Casio-Byte/Pico-Latency-Tester/LCD-Version/images/screens/08b_menu_trigger_default.png

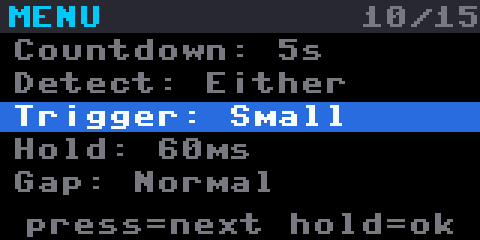
LCD-Version/images/screens/08b_menu_trigger_default.png
