Casio-Byte/Pico-Latency-Tester/LCD-Version/images/screens/09_menu_clicks.png

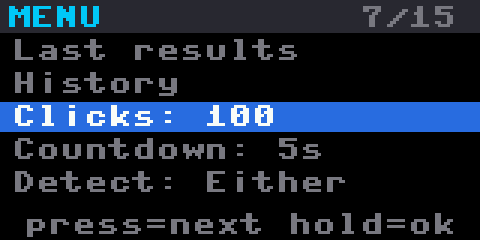
LCD-Version/images/screens/09_menu_clicks.png
