Casio-Byte/Pico-Latency-Tester/LCD-Version/images/screens/15c_flicker_dark.png

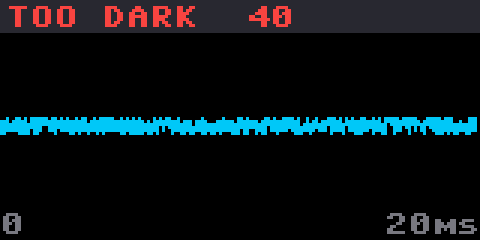
LCD-Version/images/screens/15c_flicker_dark.png
