Casio-Byte/Pico-Latency-Tester/LCD-Version/images/screens/18_flipped_menu.png

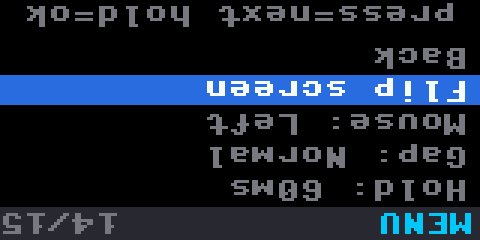
LCD-Version/images/screens/18_flipped_menu.png
