Casio-Byte/Pico-Latency-Tester/LCD-Version/images/screens/20_no_change.png

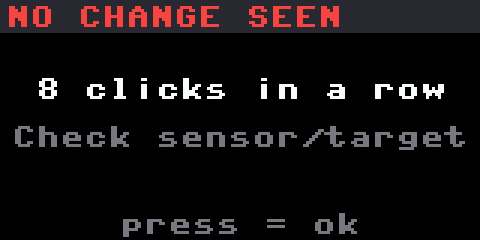
LCD-Version/images/screens/20_no_change.png
