Casio-Byte/Pico-Latency-Tester/LCD-Version/case/parametric/latency_v3_lid.stl

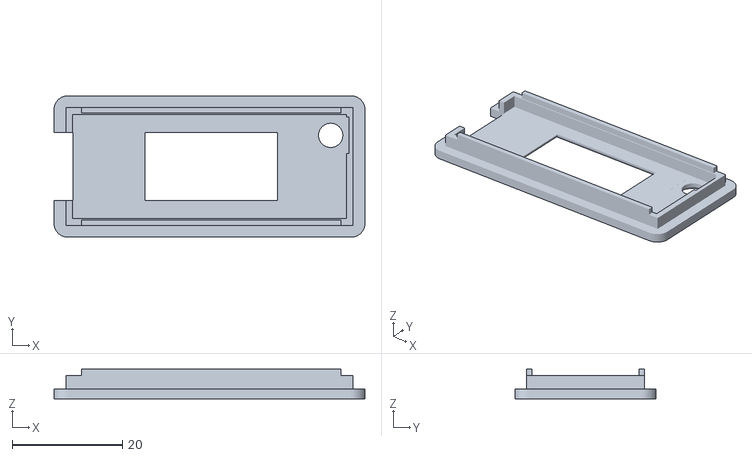
[picture p34: CAD file, 2026-10-23]
LCD-Version/case/parametric/latency_v3_lid.stl
56.3 x 25.6 x 5.40
