Casio-Byte/Pico-Latency-Tester/LCD-Version/case/parametric/latency_v3_base.stl

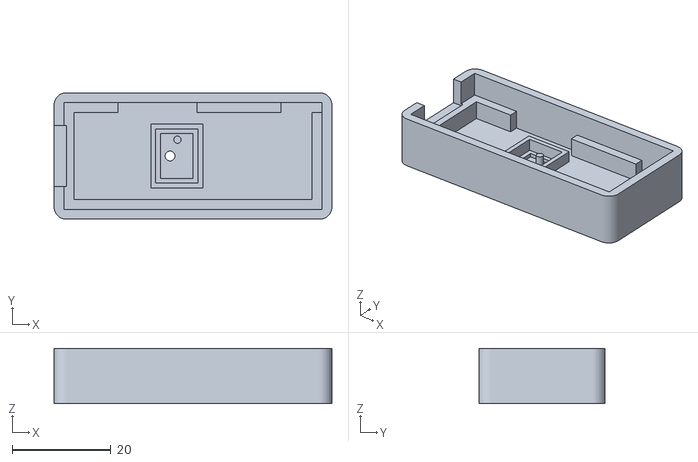
[picture p35: CAD file, 2026-10-23]
LCD-Version/case/parametric/latency_v3_base.stl
56.3 x 25.6 x 11.2
