Casio-Byte/Pico-Latency-Tester/LCD-Version/images/screens/17e_history_cleared.png

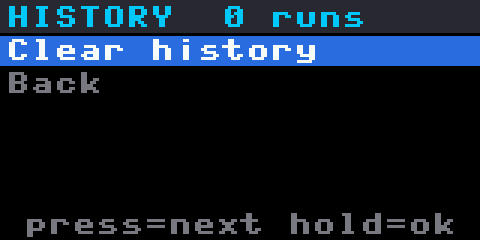
LCD-Version/images/screens/17e_history_cleared.png
