Casio-Byte/Pico-Latency-Tester/(commit log)

2026-10-23 Pico Latency Tester 2.1: Pico firmware, Windows app and write-up
    Click-to-photon latency tester built from a Raspberry Pi Pico / Pico W and an
    ALS-PT19 light sensor. The Pico acts as a USB mouse plus serial port; a native
    Windows app (C++, Dear ImGui, Direct3D 11) runs the tests.
    - Firmware: viper hot paths, free-running ADC, microsecond click-to-light timing
    - App: built-in full-screen/windowed flash target with latency breakdown,
    game/any-app test, response and flicker scope, live sensor, history and
    comparison, CSV export, firmware installer via the MicroPython raw REPL
    - Tests: core unit tests, firmware mpy-cross check, simulated-Pico Wine bench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
2026-10-23 Add standalone version 3: RP2040-LCD screen + one button, no PC app
    - standalone/: firmware for the Waveshare RP2040-LCD-0.96 with an ALS-PT19
    sensor and one button. One-button menus, auto runs with calibration,
    manual mode (button = mouse), response scope, flicker test, sensor view,
    results pages, history; settings and results saved on the board
    - lt_app.py runs unchanged against a simulated board
    (tests/sim_standalone.py) - used to test every screen and to render the
    screenshots with MicroPython's own font
    - pre-compiled .mpy modules, a simple target.html for the PC
    - README links both versions
    Claude-Session: https://claud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
2026-10-23 Standalone v3.1: remove manual test, fix flicker test, live sensor view, history browse/clear
    - Remove manual test mode (and the hardware code behind it)
    - Flicker test: countdown, holds the mouse so the target is lit, no longer
    runs out of memory (no 16000-item sorted copy; capture buffer allocated
    once at boot), shows TOO DARK when the sensor sees no light
    - Any out-of-memory error in a menu action now shows a message instead of
    crashing
    - Sensor view redraws every sample; press sends a click, hold goes back
    - History: browse every run, open one for its detail, clear all (confirmed)
    - Trigger defaults to Small; existing boards are moved over once
    - Simulator: 84 steps covering the ne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
    [lt_app.py, lt_hw.py]
2026-10-23 Standalone: button moves to GP16 (pin 21) and GND (pin 23)
    Claude-Session: https://claude.ai/code/session_01NdawBg2AjAfE4fo9pBicW9
2026-10-23 Standalone: 3D-printed case for the RP2040-LCD-0.96
    Screen through the lid, button soldered on the board through a hole in the
    lid, ALS-PT19 in a pocket under the board looking out of the back. Board
    rests on a ledge (gaps for solder joints), push-fit lid, USB-C slot.
    STLs, OpenSCAD source and preview renders.
    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
    [latency_tester_v3_case.scad, latency_v3_base.stl, latency_v3_lid.stl]
2026-10-24 Separate the LCD version into LCD-Version/ and add its case model
    - standalone/ -> LCD-Version/, self-contained: own README, USB library (lib/),
    screenshots (images/screens), compiled files, tests
    - New case: LCD-Version/case/Pico_Latency_Tester_LCD.stl (case + button cap,
    strap loops, sensor hole in the back) with renders
    - Earlier OpenSCAD case kept in LCD-Version/case/parametric/
    - Main README: side-by-side table of the two separate versions; changelog,
    project layout and licence notes updated
    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
    [Pico_Latency_Tester_LCD.stl, latency_tester_v3_case.scad, latency_v3_base.stl, latency_v3_lid.stl]
2026-10-24 Revert "Separate the LCD version into LCD-Version/ and add its case model"
    The LCD version moves to its own repository instead:
    https://github.com/Casio-Byte/Pico-Latency-Tester-LCD
    This reverts commit 9673cc5.
    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
    [Pico_Latency_Tester_LCD.stl, latency_tester_v3_case.scad, latency_v3_base.stl, latency_v3_lid.stl]
2026-10-24 Move the LCD version to its own repository
    The LCD version (v3.x) now lives in
    This repository is the PC app version; the README links to the other one.
    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
    [latency_tester_v3_case.scad, latency_v3_base.stl, latency_v3_lid.stl]
